beratgursess22/ASRS-System/ERP-ASRS/ASRS.Web/wwwroot/models/asrs-system.step

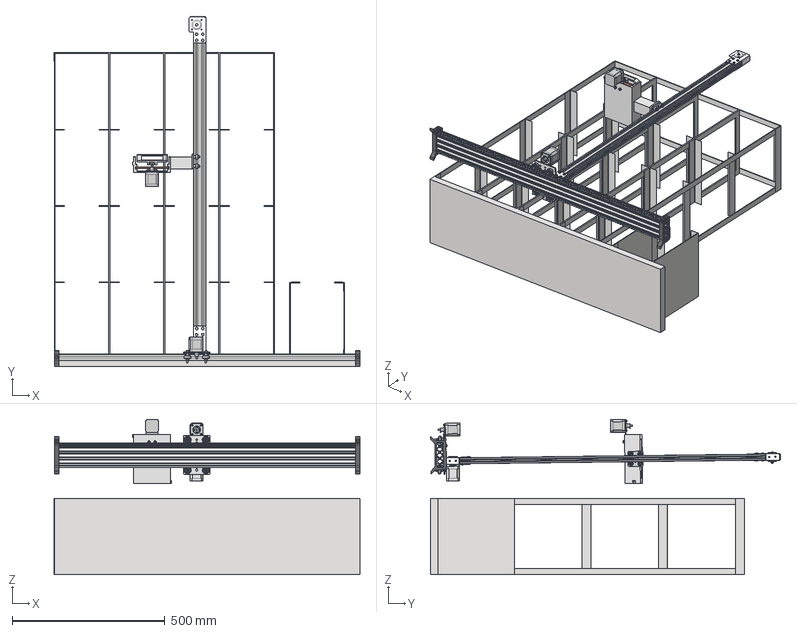
[picture p1: CAD file, 2026-04-13]
ERP-ASRS/ASRS.Web/wwwroot/models/asrs-system.step
1000.5 x 1145.4 x 508.7 mm
RAF SİSTEMİ V2
KÖŞEBENT x 38
vslot 2080
STAND x 2
V-Slot Gantry Plate - Universal 20-80mm
Aluminum Spacer 6mm x 2
Eccentric Spacer 6mm x 2
Solid V Wheel x 4
M5 Nut x 8
Nema 17 Stepper Motor x 2
Precision Shim 8 x 5 x 1 x 8
hex_socket_cylindrical_head_M3x10 x 8
hex_socket_cylindrical_head_M5x35 x 4
hex_socket_cylindrical_head_M5x16 x 2
Ball Bearing 5 x 16 x 5 x 8
Motor Mount Plate Nema 17 x 2
GT2 Timing Pulley 20 Tooth x 2
ALT MOTOR
V-Slot 20x40x1000 Linear Rail
Low Profile Screw M5 v1 x 4
Nylon Insert Lock Nut M5 x 4
Precision Shim 8 x 5 x 1_1 x 4
Eccentric Spacer 6mm v1 x 2
Aluminum Spacer 6mm_1 x 2
Mini V Wheel Plate
Delrin Mini V Wheel x 4
Ball Bearing 5 x 10 x 4.2 x 8
ÜST GÖVDE
PART C
PART D
PART B
PART AV2
hex_socket_cylindrical_head_M5x10 x 2
ARM
FORK V2 x 2
