beratgursess22/ASRS-System/(commit log)

2026-03-06 fixed stepper
2026-03-06 fixed operation.cpp and .h
    [operations.cpp]
2026-03-06 fixed serail.cpp and h
    [serial_protocol.cpp]
2026-03-11 added workorder and Bill of materials entites dtos interfaces service and index
2026-03-12 added BOM structure and added Material structure such as: entites, view, interface, service, controller
2026-03-14 fixed bom side,added some calculation for stock
2026-03-14 fixed bom and workorder status
2026-03-17 fixed some bugs for Bom side, and improve workorder page
2026-03-20 create the relationship pricing and material products
2026-04-13 added dashboard for ASRSsystem
    [SİSTEM MONTAJ.step, asrs-system.step]
2026-04-13 added protocl for arduino
2026-04-20 ASRS APı serial config ayarlandı raspberry için
2026-04-20 raspberry communication py
2026-04-24 fixed some bug for ardunio mega
    [ASRS_Main_Single.ino, axes.cpp]
